EqUiNoX-Labs/OpenXenium/Hardware/Xenium2019.brd

## EAGLE design Hardware/Xenium2019.brd (2021-10-10)

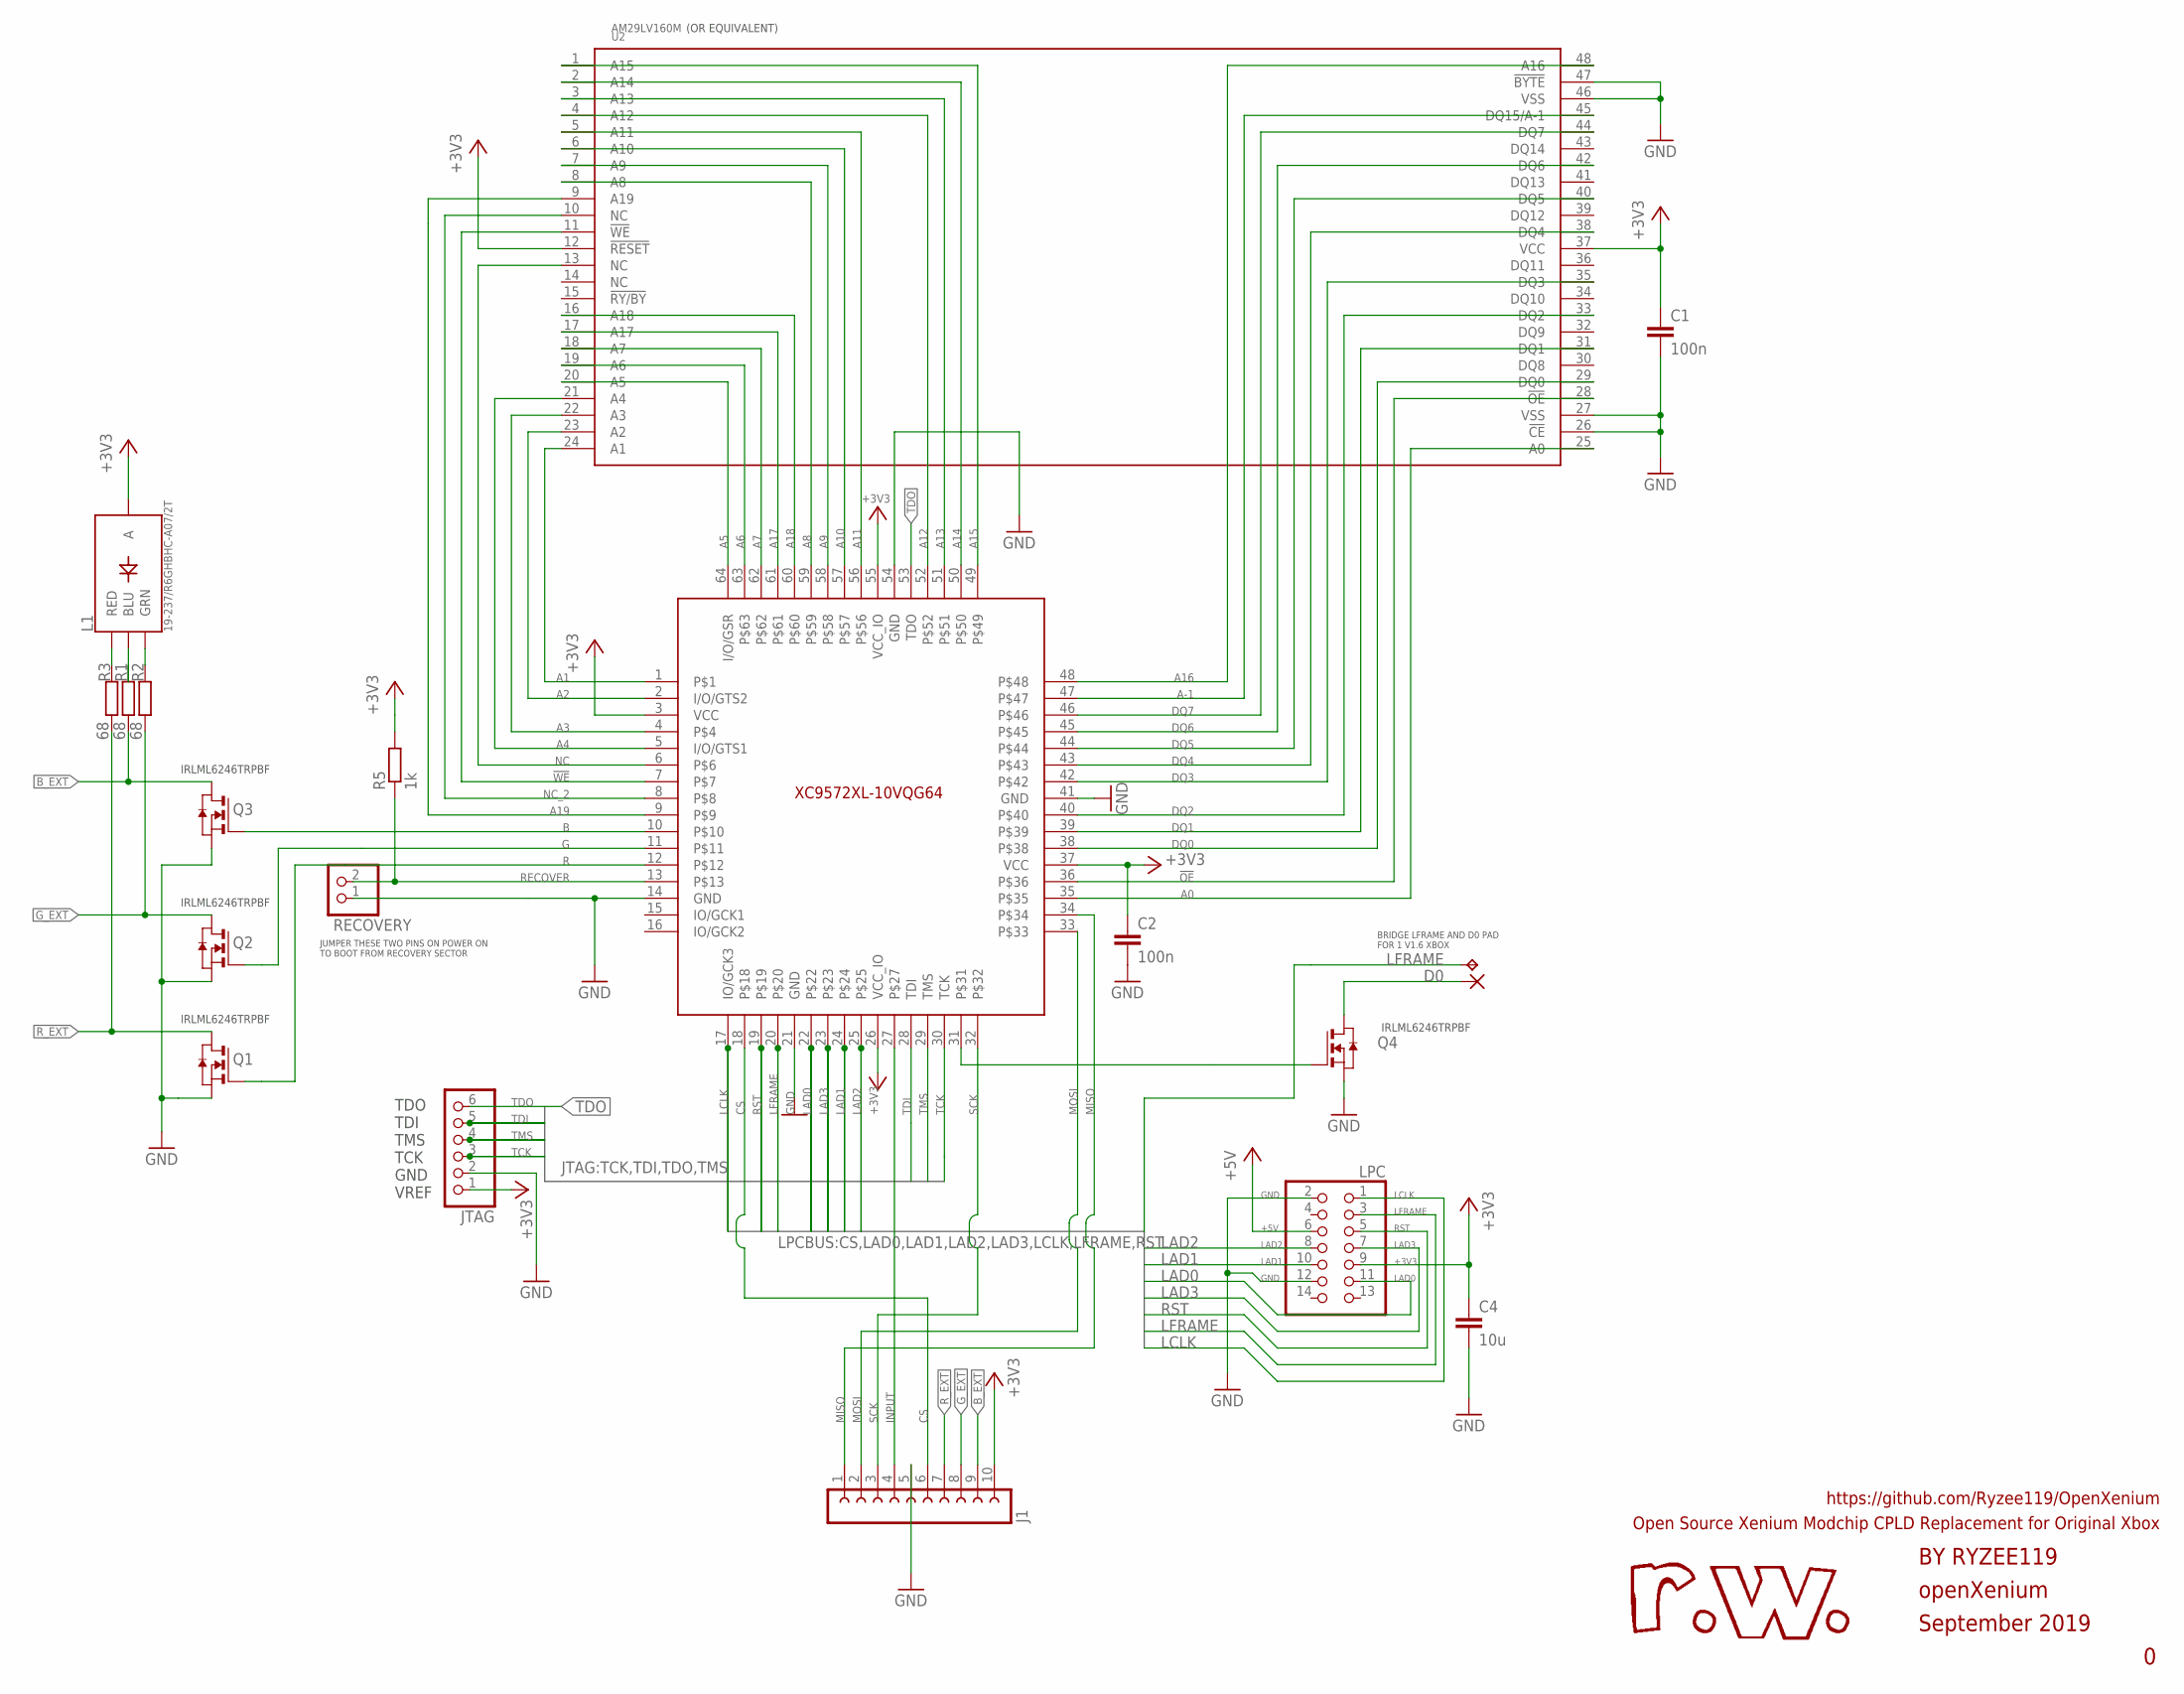
[picture p1: schematic Xenium2019.sch]

Parts:
C1, C2: 100n; C0603
C4: 10u; C0603
D0: SMD2; SMD1,27-2,54
J1: FE10-1; FE10
JTAG: PINHD-1X6; 1X06
L1: 19-237/R6GHBHC-A07/2T; 4-SMD-R6GHBHC
LPC: PINHD-2X7; 2X07
Q1, Q2, Q3, Q4: 310mA/60V/1.6Ω; SOT-23
R1, R2, R3: 68; R0603
R5: 1k; R0603
RECOVERY: PINHD-1X2; 1X02
TP1: TPTP13SQ; TP13SQ
U1: XC9572XL-10VQG64; LQFP64
U2: AM29LV160M; TSOP48

Connections:
!OE: U1.36, U2.28 (!OE)
!WE: U1.7, U2.11 (!WE)
+3V3: C1.1, C2.1, C4.1, J1.10, JTAG.1, L1.P$2 (A), LPC.9, R5.2, U1.3 (VCC), U1.26 (VCC_IO), U1.37 (VCC), U1.55 (VCC_IO), U2.12 (!RESET), U2.37 (VCC)
+5V: LPC.6
A0: U1.35, U2.25 (A0)
A1: U1.1, U2.24 (A1)
A2: U1.2 (I/O/GTS2), U2.23 (A2)
A3: U1.4, U2.22 (A3)
A4: U1.5 (I/O/GTS1), U2.21 (A4)
A5: U1.64 (I/O/GSR), U2.20 (A5)
A6: U1.63, U2.19 (A6)
A7: U1.62, U2.18 (A7)
A8: U1.59, U2.8 (A8)
A9: U1.58, U2.7 (A9)
A10: U1.57, U2.6 (A10)
A11: U1.56, U2.5 (A11)
A12: U1.52, U2.4 (A12)
A13: U1.51, U2.3 (A13)
A14: U1.50, U2.2 (A14)
A15: U1.49, U2.1 (A15)
A16: U1.48, U2.48 (A16)
A17: U1.61, U2.17 (A17)
A18: U1.60, U2.16 (A18)
A19: U1.9, U2.9 (A19)
A-1: U1.47, U2.45 (DQ15/A-1)
B: Q3.3 (G), U1.10
BLUE: L1.P$4 (BLU), R1.1
B_EXT: J1.9, Q3.1 (D), R1.2
CS: J1.6, U1.18
DQ0: U1.38, U2.29 (DQ0)
DQ1: U1.39, U2.31 (DQ1)
DQ2: U1.40, U2.33 (DQ2)
DQ3: U1.42, U2.35 (DQ3)
DQ4: U1.43, U2.38 (DQ4)
DQ5: U1.44, U2.40 (DQ5)
DQ6: U1.45, U2.42 (DQ6)
DQ7: U1.46, U2.44 (DQ7)
G: Q2.3 (G), U1.11
GND: C1.2, C2.2, C4.2, J1.5, JTAG.2, LPC.2, LPC.12, Q1.2 (S), Q2.2 (S), Q3.2 (S), Q4.2 (S), RECOVERY.1, U1.14 (GND), U1.21 (GND), U1.41 (GND), U1.54 (GND), U2.26 (!CE), U2.27 (VSS), U2.46 (VSS), U2.47 (!BYTE)
GREEN: L1.P$3 (GRN), R2.1
G_EXT: J1.8, Q2.1 (D), R2.2
INPUT: J1.4, U1.27
LAD0: LPC.11, U1.22
LAD1: LPC.10, U1.24
LAD2: LPC.8, U1.25
LAD3: LPC.7, U1.23
LCLK: LPC.1, U1.17 (IO/GCK3)
LFRAME: LPC.3, TP1.TP, U1.20
MISO: J1.1, U1.34
MOSI: J1.2, U1.33
unnamed: Q4.3 (G), U1.31
unnamed: D0.1, Q4.1 (D)
NC: U1.6, U2.13 (NC)
NC_2: U1.8, U2.10 (NC)
R: Q1.3 (G), U1.12
RECOVER: R5.1, RECOVERY.2, U1.13
RED: L1.P$1 (RED), R3.1
RST: LPC.5, U1.19
R_EXT: J1.7, Q1.1 (D), R3.2
SCK: J1.3, U1.32
TCK: JTAG.3, U1.30 (TCK)
TDI: JTAG.5, U1.28 (TDI)
TDO: JTAG.6, U1.53 (TDO)
TMS: JTAG.4, U1.29 (TMS)

Notes on the sheet:
TDO TDI TMS TCK GND VREF
openXenium
September 2019
BY RYZEE119
Open Source Xenium Modchip CPLD Replacement for Original Xbox
https://github.com/Ryzee119/OpenXenium
BRIDGE LFRAME AND D0 PAD FOR 1 V1.6 XBOX
JUMPER THESE TWO PINS ON POWER ON TO BOOT FROM RECOVERY SECTOR
IRLML6246TRPBF
(OR EQUIVALENT)

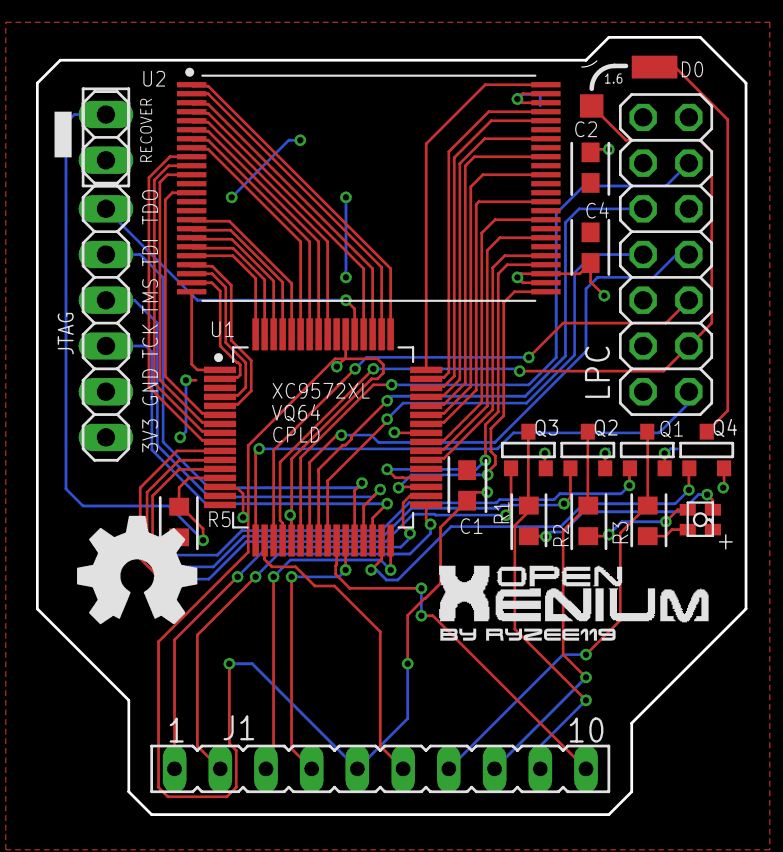
[picture p2: board Xenium2019.brd from above]

Board: 2 copper layers, 39.4 x 43.2 mm, 20 parts (0 on the bottom side), 63 nets.
