EqUiNoX-Labs/OpenXenium/(commit log)

2021-10-10 Update: added pads
    [Xenium2019.brd, Xenium2019.sch]
2021-10-10 Update: wired header
    [Xenium2019.brd]
